pavlokostushevych/Nixie-Tube-Clock/photos/5.Completed Test Module.jpg

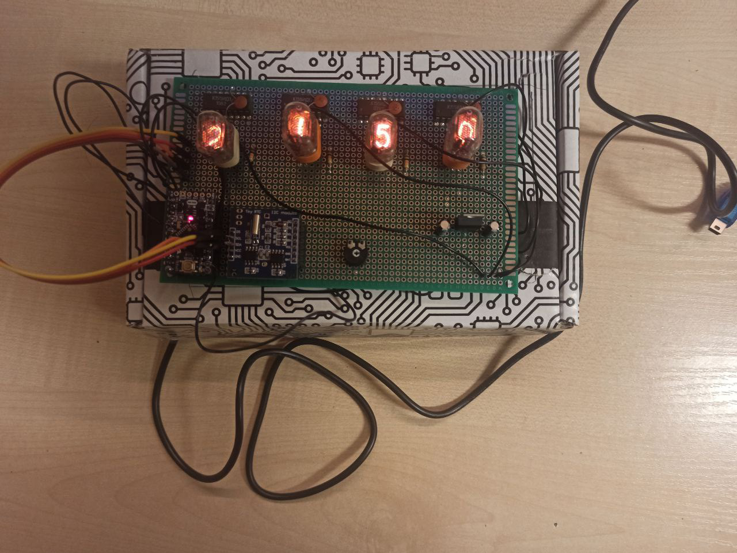
photos/5.Completed Test Module.jpg
