pavlokostushevych/Nixie-Tube-Clock/photos/2.Soldering Connections on the Bottom Side of the Board.jpg

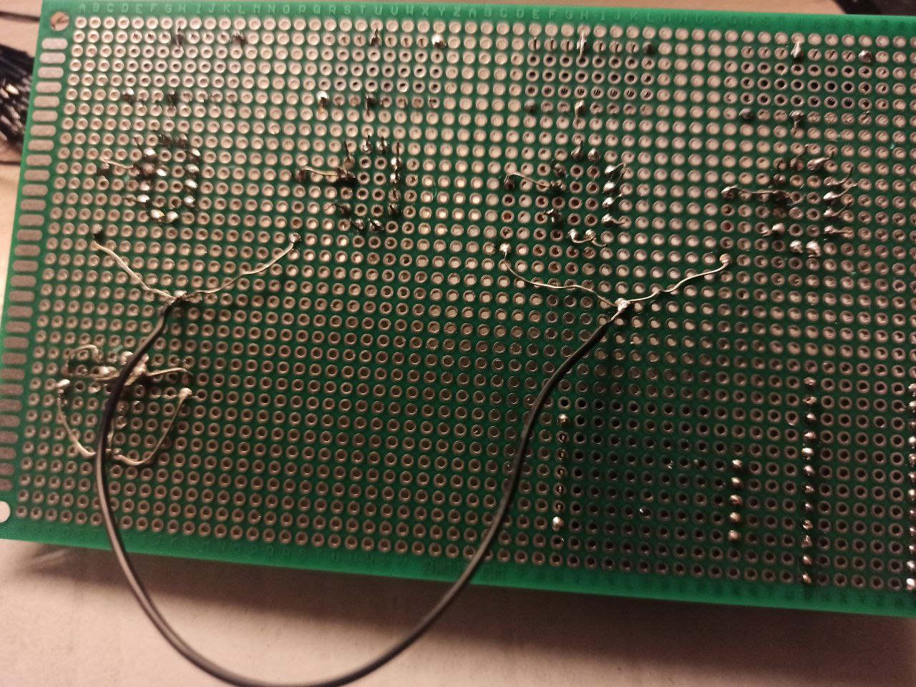
photos/2.Soldering Connections on the Bottom Side of the Board.jpg
