pavlokostushevych/Nixie-Tube-Clock/README.md

📄 Wersja polska poniżej – [Przejdź do wersji PL](#PL)

# ⏰ Nixie Tube Clock

Clock project using IN-17 Nixie tubes controlled by Arduino Pro Mini and synchronized with DS1307 RTC.

---

## 📂 Project Structure

- [`docs/`](./docs) — Project documentation PDFs  
  - [Nixie_Clock_Project_Presentation.pdf (English)](docs/Nixie_Clock_Project_Presentation.pdf)  
  - [Prezentacja_Projektu_Zegara_Nixie.pdf (Polish)](docs/Prezentacja_Projektu_Zegara_Nixie.pdf)
  - [Arduino Code](docs/nixieclock.ino)

- [`video/`](./video) — Project videos  
  - [Nixie Tube Digit Display Test.mp4](video/Nixie%20Tube%20Digit%20Display%20Test.mp4) — local video demonstrating digits test  
  - YouTube link: [Nixie Tube Digit Display Test on YouTube](https://youtube.com/shorts/KTlzbwLbgn8?feature=share)

- [`photos/`](./photos) — Photos documenting the project  
  - [Electronic Schematic (KiCad).png](photos/Electronic%20Schematic%20(KiCad).png) — schematic diagram  
  - Photos of soldering and power-on process

---

## 🛠️ Project Description

This project showcases a digital clock built using Nixie tubes (IN-17) driven by an Arduino Pro Mini and synchronized via DS1307 RTC module. The repository includes:

- Circuit schematic designed in KiCad  
- Complete Arduino code with comments  
- Assembly and soldering documentation with photos and videos  
- Testing videos showing all digits on the Nixie tubes

---

## 📁 How to Use

- Review the detailed documentation in the [`docs/`](./docs) folder.  
- Watch the digit display test video in the [`video/`](./video) folder or on [YouTube](https://youtube.com/shorts/KTlzbwLbgn8?feature=share).  
- Check the [`photos/`](./photos) folder for schematic and assembly images.

---

## 📬 Contact

For any questions, please reach out:  
Email: pavlo.kostushevych@gmail.com  
LinkedIn: [linkedin.com/in/pavlo-kostushevych-ab364b376](https://linkedin.com/in/pavlo-kostushevych-ab364b376)

---

# PL

## ⏰ Zegar na lampach Nixie

Projekt zegara cyfrowego z wykorzystaniem lamp IN-17, sterowanego Arduino Pro Mini i synchronizowanego modułem RTC DS1307.

---

## 📂 Struktura projektu

- [`docs/`](./docs) — Dokumentacja projektu w formacie PDF  
  - [Nixie_Clock_Project_Presentation.pdf (English)](docs/Nixie_Clock_Project_Presentation.pdf)  
  - [Prezentacja_Projektu_Zegara_Nixie.pdf (Polish)](docs/Prezentacja_Projektu_Zegara_Nixie.pdf)
  - [Arduino kod](docs/nixieclock.ino)

- [`video/`](./video) — Filmy dokumentujące projekt  
  - [Nixie Tube Digit Display Test.mp4](video/Nixie%20Tube%20Digit%20Display%20Test.mp4) — lokalne wideo testujące wyświetlanie cyfr  
  - Link do YouTube: [Test wyświetlania cyfr na lampach Nixie](https://youtube.com/shorts/KTlzbwLbgn8?feature=share)

- [`photos/`](./photos) — Zdjęcia dokumentujące projekt  
  - [Electronic Schematic (KiCad).png](photos/Electronic%20Schematic%20(KiCad).png) — schemat elektroniczny  
  - Zdjęcia procesu lutowania i uruchomienia

---

## 🛠️ Opis projektu

Projekt prezentuje zegar cyfrowy oparty na lampach Nixie (IN-17), sterowany mikrokontrolerem Arduino Pro Mini i synchronizowany modułem RTC DS1307. Repozytorium zawiera:

- Schemat układu w KiCad  
- Pełny kod Arduino z komentarzami  
- Dokumentację montażu i lutowania wraz ze zdjęciami i filmami  
- Filmy z testami wyświetlania cyfr na lampach Nixie

---

## 📁 Jak korzystać

- Zapoznaj się z dokumentacją w folderze [`docs/`](./docs).  
- Obejrzyj film testowy w folderze [`video/`](./video) lub na [YouTube](https://youtube.com/shorts/KTlzbwLbgn8?feature=share).  
- Sprawdź zdjęcia w folderze [`photos/`](./photos).

---

## 📬 Kontakt

W razie pytań proszę o kontakt:  
Email: pavlo.kostushevych@gmail.com  
LinkedIn: [linkedin.com/in/pavlo-kostushevych-ab364b376](https://linkedin.com/in/pavlo-kostushevych-ab364b376)
