pavlokostushevych/Nixie-Tube-Clock/photos/3.After completing most of the connections.jpg

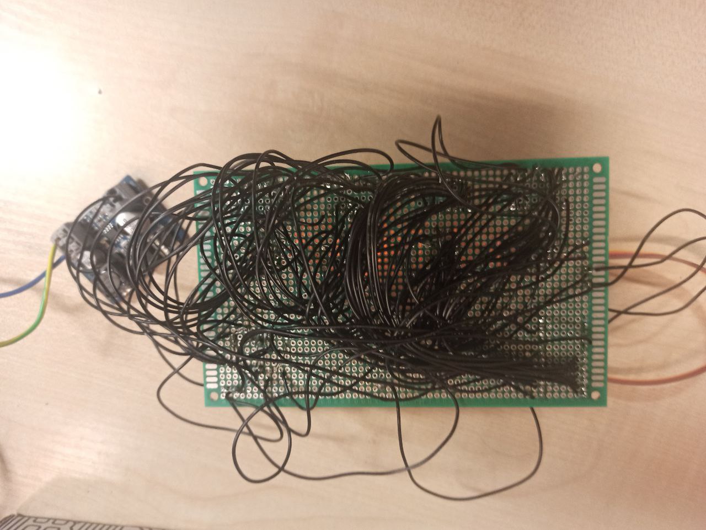
photos/3.After completing most of the connections.jpg
