pavlokostushevych/Nixie-Tube-Clock/photos/4.First Power-Up of the Circuit.jpg

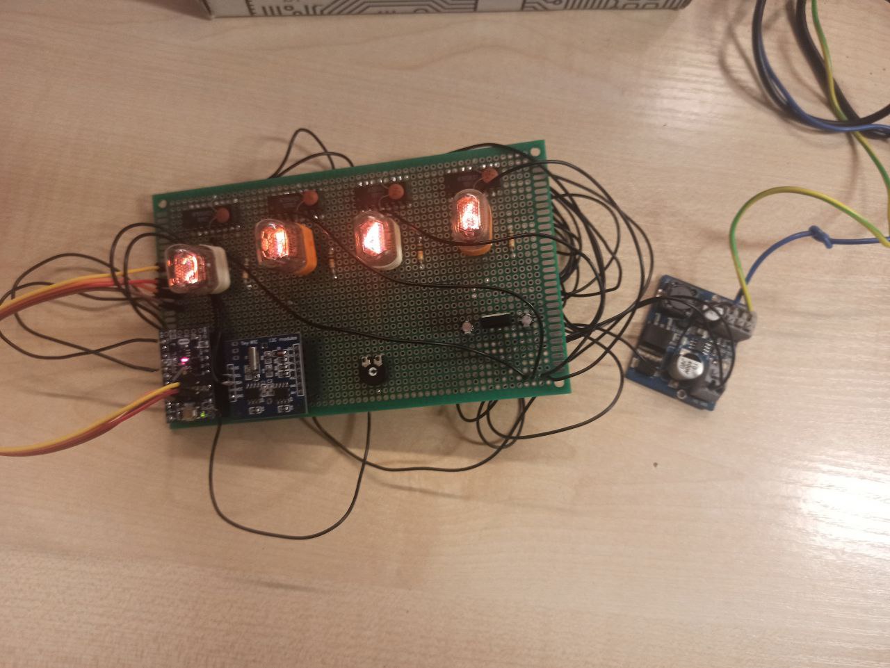
photos/4.First Power-Up of the Circuit.jpg
