pavlokostushevych/Nixie-Tube-Clock/(commit log)

2025-08-01 Rename Soldering Connections on the Bottom Side of the Board.jpg to 2.Soldering Connections on the Bottom Side of the Board.jpg
2025-08-01 Rename Assembly and Soldering of the Nixie Tube Clock.jpg to 1.Assembly and Soldering of the Nixie Tube Clock.jpg
2025-08-01 Rename First Power-Up of the Circuit.jpg to 4.First Power-Up of the Circuit.jpg
